gifter77/PCB-reflow-solder-heat-plate/Heatplate_v2.0/Heatplate_v2.0.pdf

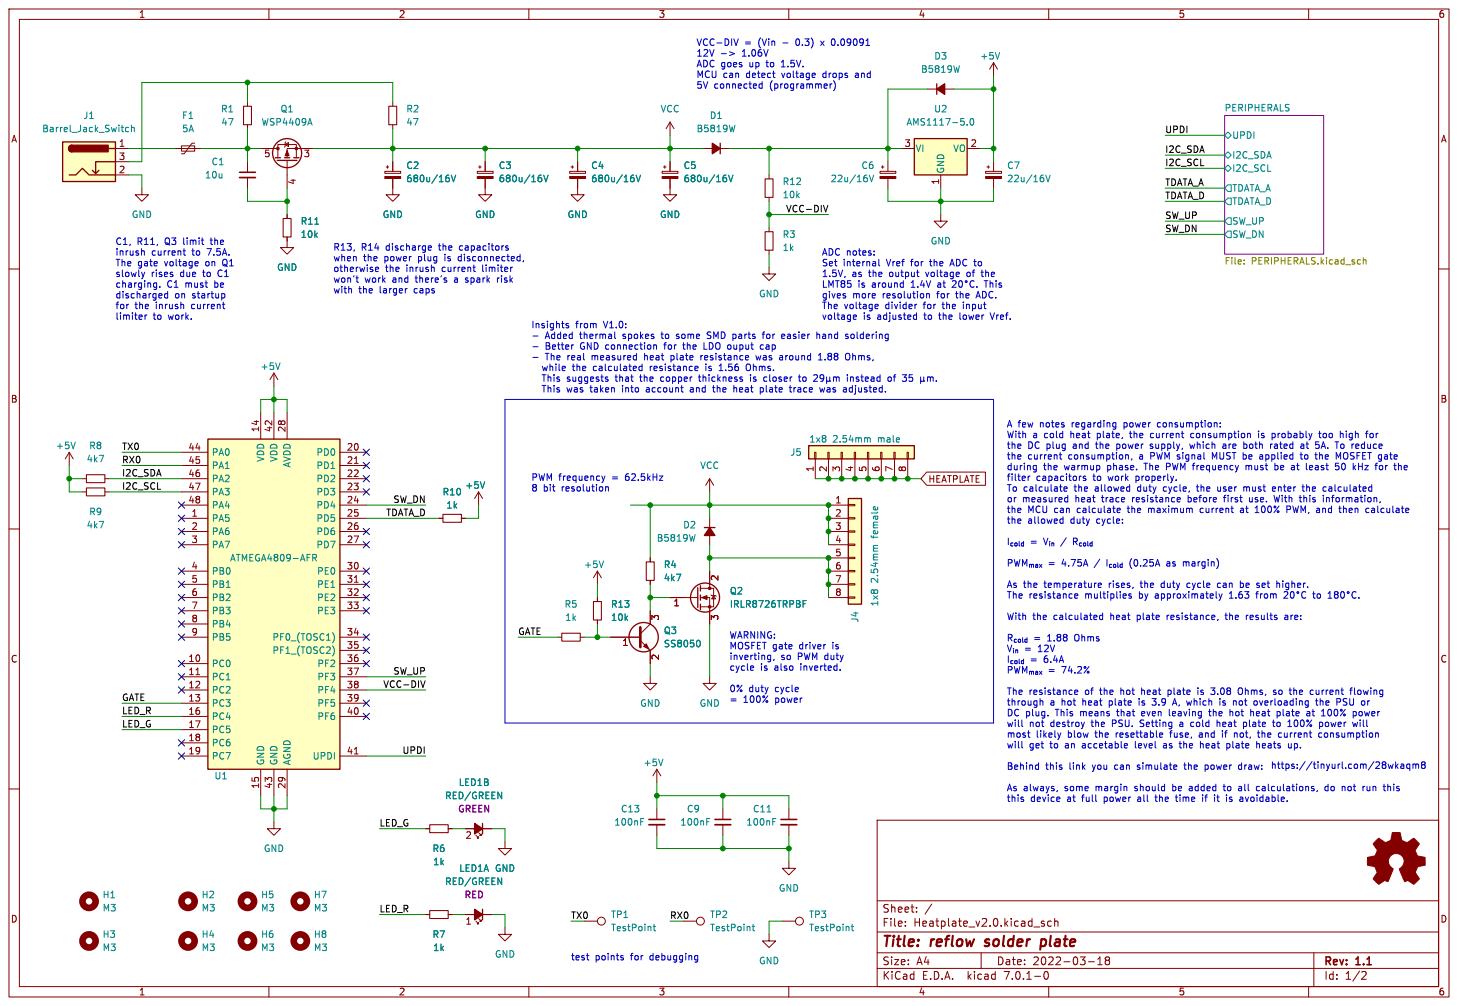
[picture p1: page 1]

VCC-DIV = (Vin - 0.3) x 0.09091
ADC goes up to 1.5V. MCU can detect voltage drops and
GND

SW_UP WARNING: MOSFET gate driver is

inrush current to 7.5A. The gate voltage on Q1
slowly rises due to C1
for the inrush current

1.5V, as the output voltage of the

voltage is adjusted to the lower Vref.

Insights from V1.0: - Added thermal spokes to some SMD parts for easier hand soldering

2 3 Q3 SS8050 PA5 1 PC0 10 PC1 11 PC2 12 PC3 13 VDD 14 GND 15 PC4 16 PC5 17 PC6 18 PC7 19 PA6 2 PD0 20 PD1 21 PD2 22 PD3 23 PD4 24 PD5 25 PD6 26 PD7 27 AVDD 28 AGND 29 PA7 3 PE0 30 PE1 31 PE2 32 PE3 33 PF0_(TOSC1) 34 PF1_(TOSC2) 35 PF2 36 PF3 37 PF4 38 PF5 39 PB0 4 PF6 40 UPDI 41 VDD 42 GND 43 PA0 44 PA1 45 PA2 46 PA3 47 PA4 48 PB1 5 PB2 6 PB3 7 PB4 8 PB5 9 U1 ATMEGA4809-AFR GND

the DC plug and the power supply, which are both rated at 5A. To reduce

the allowed duty cycle:

this device at full power all the time if it is avoidable.

Id: 1/2 Title: reflow solder plate

test points for debugging

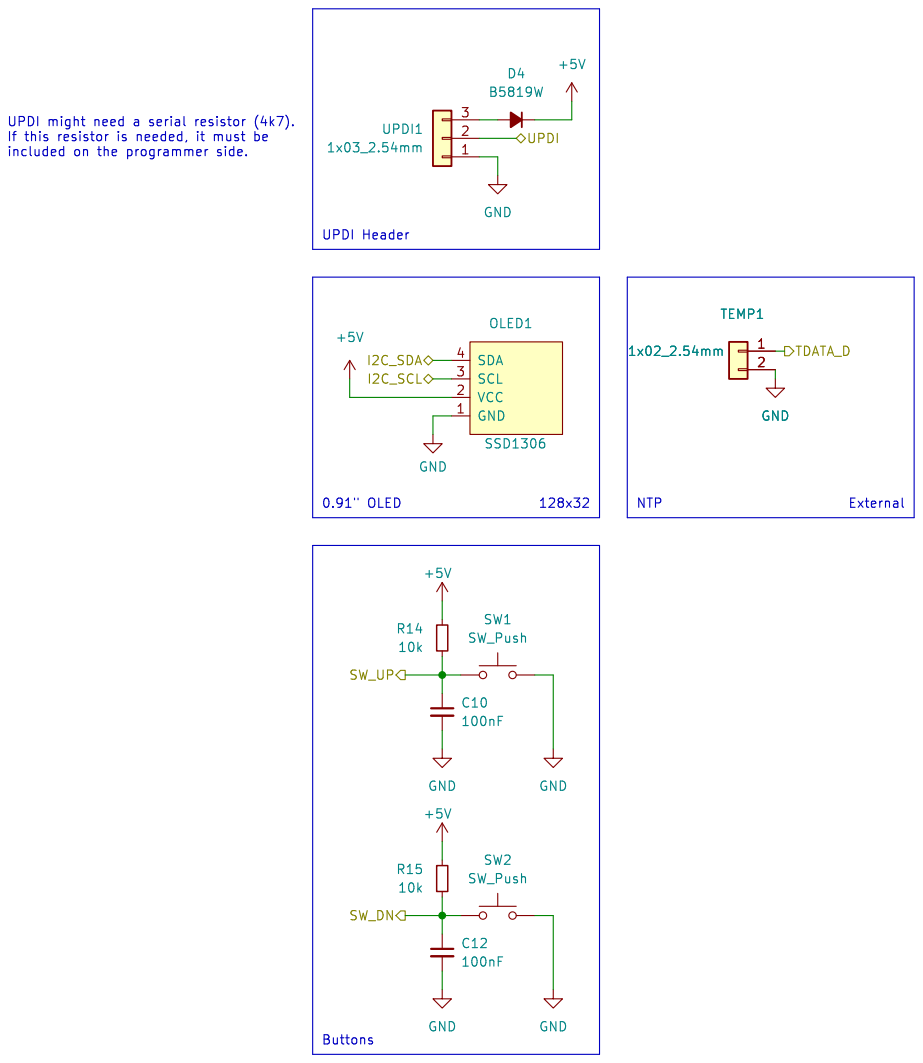
[picture p2: page 2]
