gifter77/PCB-reflow-solder-heat-plate/Heatplate_v2.0/Heatplate_v2.0.kicad_pcb

## KiCad design Heatplate_v2.0/Heatplate_v2.0.kicad_pcb (2023-04-24)

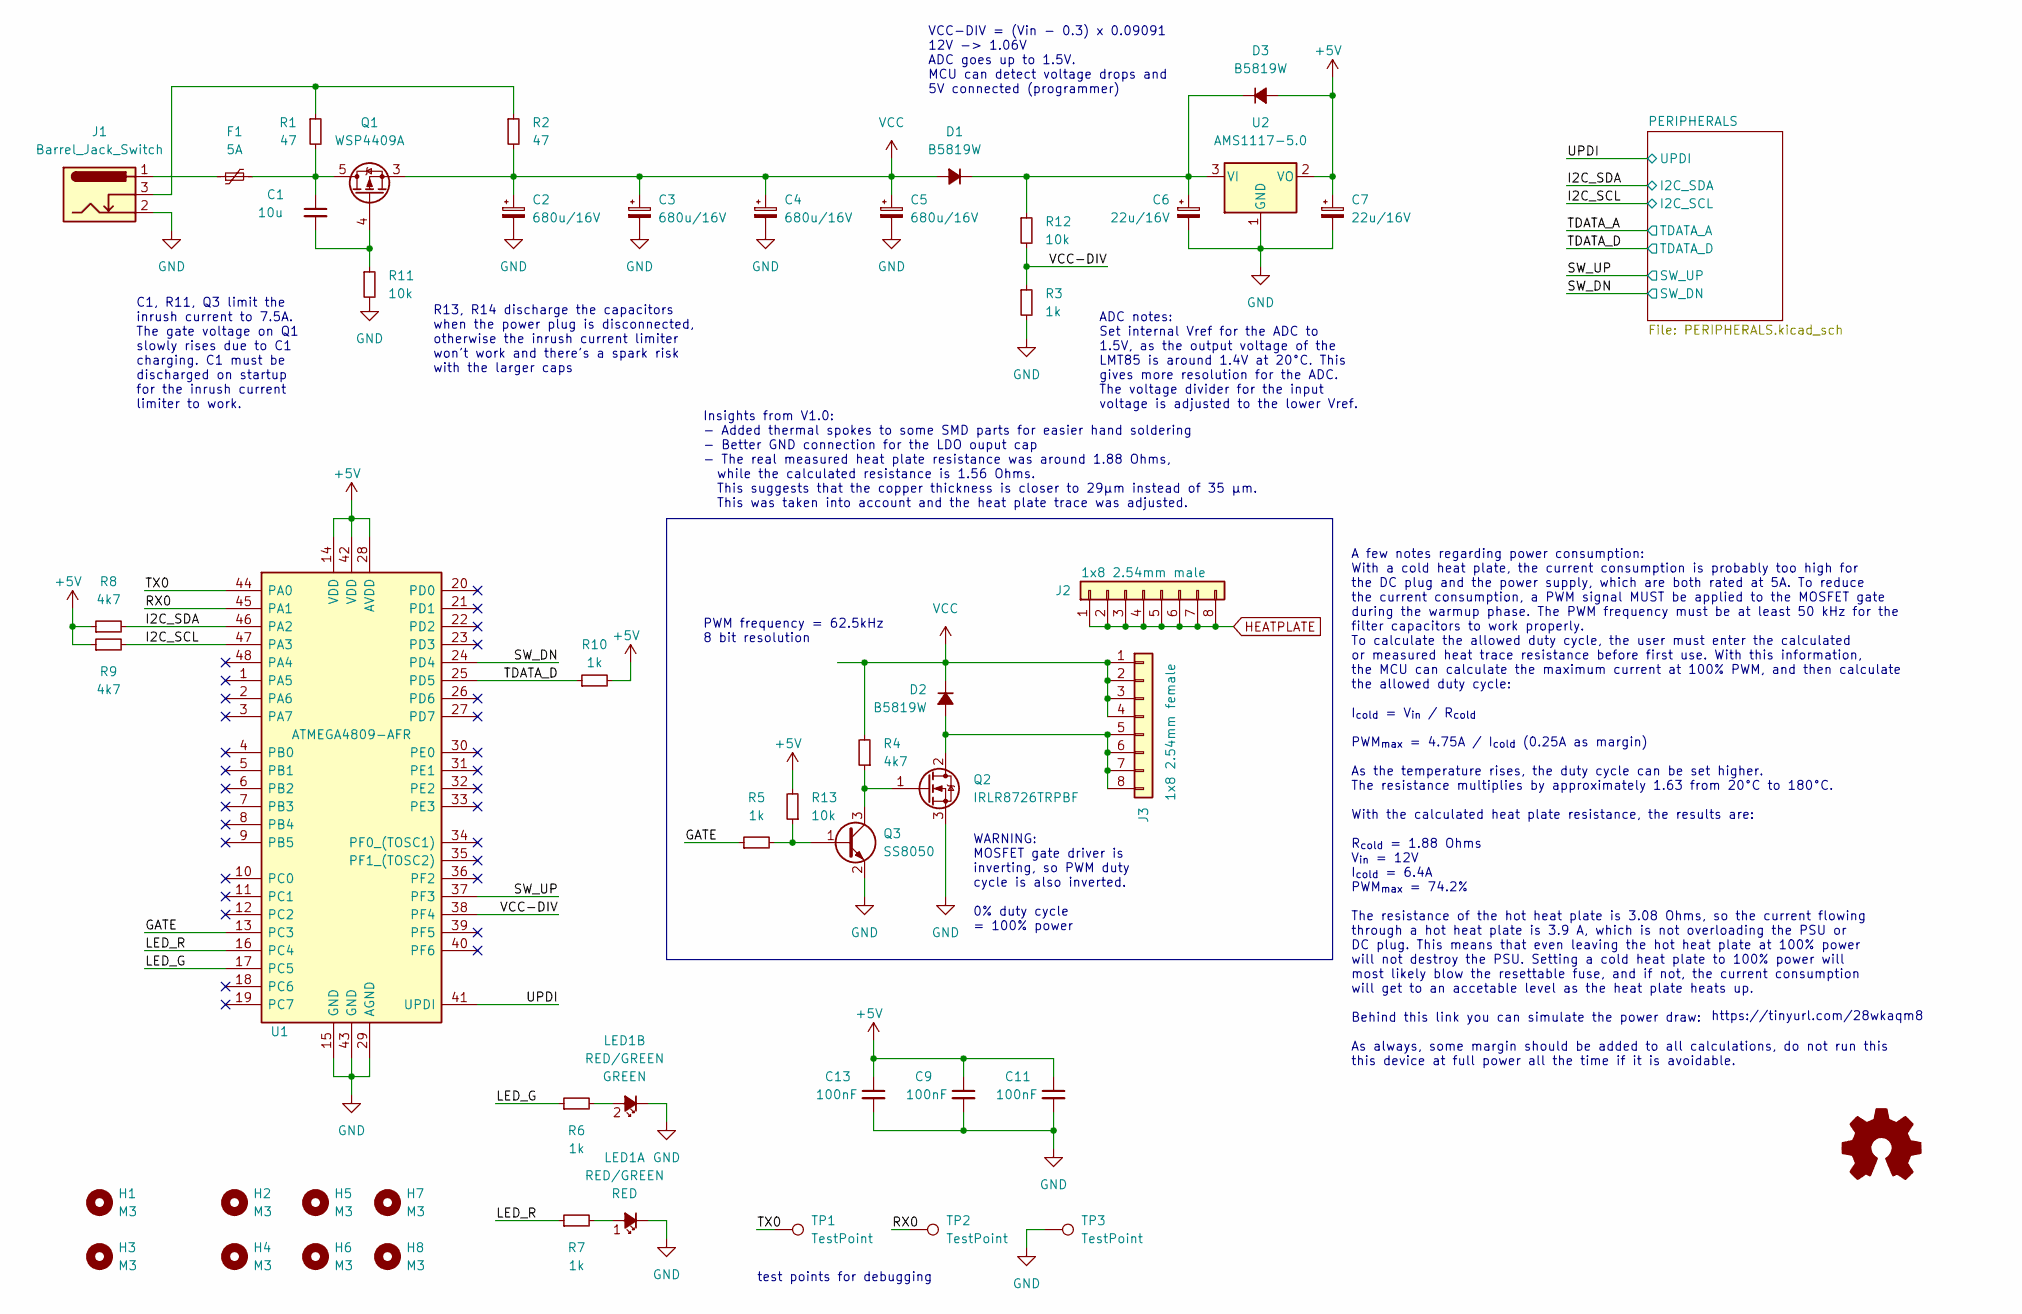
[picture p3: schematic Heatplate_v2.0.kicad_sch, reflow solder plate]

Parts:
C1: 10u; C_0805_2012Metric; LCSC Part Number C2922480
C2, C3, C4, C5: 680u/16V; CP_Radial_D8.0mm_P3.50mm; LCSC Part Number C88760
C6, C7: 22u/16V; CP_Elec_4x5.4; LCSC Part Number C88799
C9, C11, C13: 100nF; C_0805_2012Metric; LCSC Part Number C1711
D1, D2, D3: B5819W; D_SOD-123; LCSC Part Number C64885
F1: 5A; Fuse_2920_7451Metric; LCSC Part Number C910846
H1, H2, H3, H4, H5, H6, H7, H8: M3; MountingHole_3.2mm_M3; LCSC Part Number C551332
J1: Barrel_Jack_Switch; BarrelJack_Horizontal; LCSC Part Number C381115
J2: 1x8 2.54mm male; PinHeader_1x08_P2.54mm_Horizontal; LCSC Part Number C2905427
J3: 1x8 2.54mm female; PinSocket_1x08_P2.54mm_Horizontal; LCSC Part Number C2932682
LED1: RED/GREEN; LED_Avago_PLCC4_3.2x2.8mm_CW; LCSC Part Number C131251
LOGO1: Logo_Open_Hardware_Small; OSHW-Logo2_7.3x6mm_SilkScreen
Q1: WSP4409A; SOIC-8_3.9x4.9mm_P1.27mm; LCSC Part Number C2880527
Q2: IRLR8726TRPBF; TO-252-2; LCSC Part Number C81137
Q3: SS8050; SOT-23; LCSC Part Number C444722
R1, R2: 47; R_0805_2012Metric; LCSC Part Number C17714
R3, R5, R6, R7: 1k; R_0805_2012Metric; LCSC Part Number C17513
R4, R8, R9: 4k7; R_0805_2012Metric; LCSC Part Number C17673
R10: 1k; R_0805_2012Metric; LCSC Part Number C17673
R11, R12, R13: 10k; R_0805_2012Metric; LCSC Part Number C17414
TP1, TP2, TP3: TestPoint; TestPoint_Pad_D1.5mm
U1: ATMEGA4809-AFR; TQFP-48_7x7mm_P0.5mm; Manufacturer_Part_Number ATMEGA4809-AFR; Mouser Part Number 556-ATMEGA4809-AFR
U2: AMS1117-5.0; SOT-89-3; LCSC Part Number C351450

Connections:
+5V: C7.1, C9.1, C11.1, C13.1, D3.2 (A), R8.1, R9.1, R10.2, R13.2, U1.14 (VDD), U1.28 (AVDD), U1.42 (VDD), U2.2 (VO); also elsewhere on the board
/GATE: R5.1, U1.13 (PC3)
/I2C_SCL: R9.2, U1.47 (PA3); also elsewhere on the board
/I2C_SDA: R8.2, U1.46 (PA2); also elsewhere on the board
/LED_G: R6.1, U1.17 (PC5)
/LED_R: R7.1, U1.16 (PC4)
/RX0: TP2.1, U1.45 (PA1)
/SW_DN: U1.24 (PD4); also elsewhere on the board
/SW_UP: U1.37 (PF3); also elsewhere on the board
/TDATA_D: R10.1, U1.25 (PD5); also elsewhere on the board
/TX0: TP1.1, U1.44 (PA0)
/UPDI: U1.41 (UPDI); also elsewhere on the board
/VCC-DIV: R3.1, R12.2, U1.38 (PF4)
GND: C2.2, C3.2, C4.2, C5.2, C6.2, C7.2, C9.2, C11.2, C13.2, J1.2, LED1.2 (K1), LED1.4 (K2), Q2.3 (S), Q3.2 (E), R3.2, R11.2, TP3.1, U1.15 (GND), U1.29 (AGND), U1.43 (GND), U2.1 (GND); also elsewhere on the board
unnamed: C1.1, F1.2, Q1.5 (D), Q1.6 (D), Q1.7 (D), Q1.8 (D), R1.2
unnamed: C6.1, D1.1 (K), D3.1 (K), R12.1, U2.3 (VI)
unnamed 17: D2.2 (A), Q2.2 (D); also elsewhere on the board
unnamed: F1.1, J1.1
unnamed: J1.3, R1.1, R2.1
unnamed: LED1.1 (A1), R7.2
unnamed: LED1.3 (A2), R6.2
unnamed: C1.2, Q1.4 (G), R11.1
unnamed: Q2.1 (G), Q3.3 (C), R4.1
unnamed: Q3.1 (B), R5.2, R13.1
VCC: C2.1, C3.1, C4.1, C5.1, D1.2 (A), D2.1 (K), Q1.1 (S), Q1.2 (S), Q1.3 (S), R2.2, R4.2; also elsewhere on the board

Notes on the sheet:
C1, R11, Q3 limit the inrush current to 7.5A. The gate voltage on Q1 slowly rises due to C1 charging. C1 must be discharged on startup for the inrush current limiter to work.
VCC-DIV = (Vin - 0.3) x 0.09091 12V -> 1.06V ADC goes up to 1.5V. MCU can detect voltage drops and 5V connected (programmer)
PWM frequency = 62.5kHz 8 bit resolution
A few notes regarding power consumption: With a cold heat plate, the current consumption is probably too high for the DC plug and the power supply, which are both rated at 5A. To reduce the current consumption, a PWM signal MUST be applied to the MOSFET gate during the warmup phase. The PWM frequen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
WARNING: MOSFET gate driver is inverting, so PWM duty cycle is also inverted. 0% duty cycle = 100% power
R13, R14 discharge the capacitors when the power plug is disconnected, otherwise the inrush current limiter won't work and there's a spark risk with the larger caps
https://tinyurl.com/28wkaqm8
test points for debugging
ADC notes: Set internal Vref for the ADC to 1.5V, as the output voltage of the LMT85 is around 1.4V at 20°C. This gives more resolution for the ADC. The voltage divider for the input voltage is adjusted to the lower Vref.
Insights from V1.0: - Added thermal spokes to some SMD parts for easier hand soldering - Better GND connection for the LDO ouput cap - The real measured heat plate resistance was around 1.88 Ohms, while the calculated resistance is 1.56 Ohms. This suggests that the copper thickness is closer to 29µ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

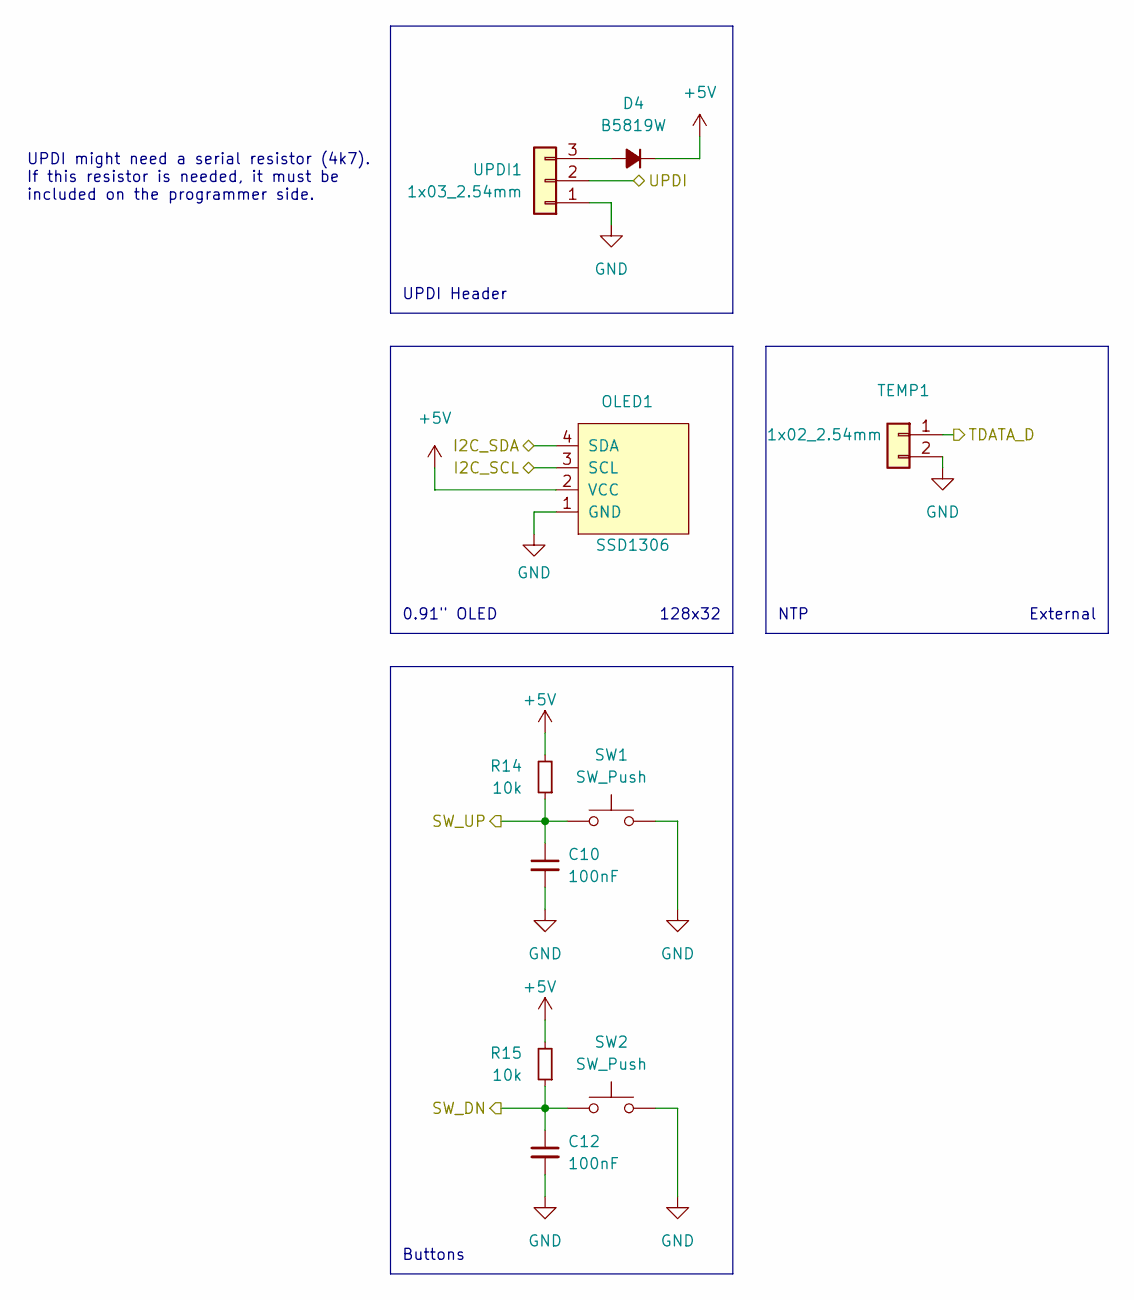
[picture p4: schematic PERIPHERALS.kicad_sch]

Parts:
C10, C12: 100nF; C_0805_2012Metric; LCSC Part Number C1711
D4: B5819W; D_SOD-123; LCSC Part Number C64885
OLED1: SSD1306; 0.91Inch-OLED-Module; LCSC Part Number C2718488
R14, R15: 10k; R_0805_2012Metric; LCSC Part Number C17414
SW1, SW2: SW_Push; SW_PUSH_6mm; LCSC Part Number C136682
TEMP1: 1x02_2.54mm; PinHeader_1x02_P2.54mm_Vertical; LCSC Part Number C2905434
UPDI1: 1x03_2.54mm; PinHeader_1x03_P2.54mm_Vertical; LCSC Part Number C49257

Connections:
+5V: D4.1 (K), OLED1.2 (VCC), R14.2, R15.2; also elsewhere on the board
/I2C_SCL: OLED1.3 (SCL); also elsewhere on the board
/I2C_SDA: OLED1.4 (SDA); also elsewhere on the board
/SW_DN: C12.1, R15.1, SW2.1; also elsewhere on the board
/SW_UP: C10.1, R14.1, SW1.1; also elsewhere on the board
/TDATA_D: TEMP1.1; also elsewhere on the board
/UPDI: UPDI1.2; also elsewhere on the board
GND: C10.2, C12.2, OLED1.1 (GND), SW1.2, SW2.2, TEMP1.2, UPDI1.1; also elsewhere on the board
unnamed: D4.2 (A), UPDI1.3

Notes on the sheet:
NTP
UPDI Header
128x32
0.91" OLED
Buttons
UPDI might need a serial resistor (4k7). If this resistor is needed, it must be included on the programmer side.
External

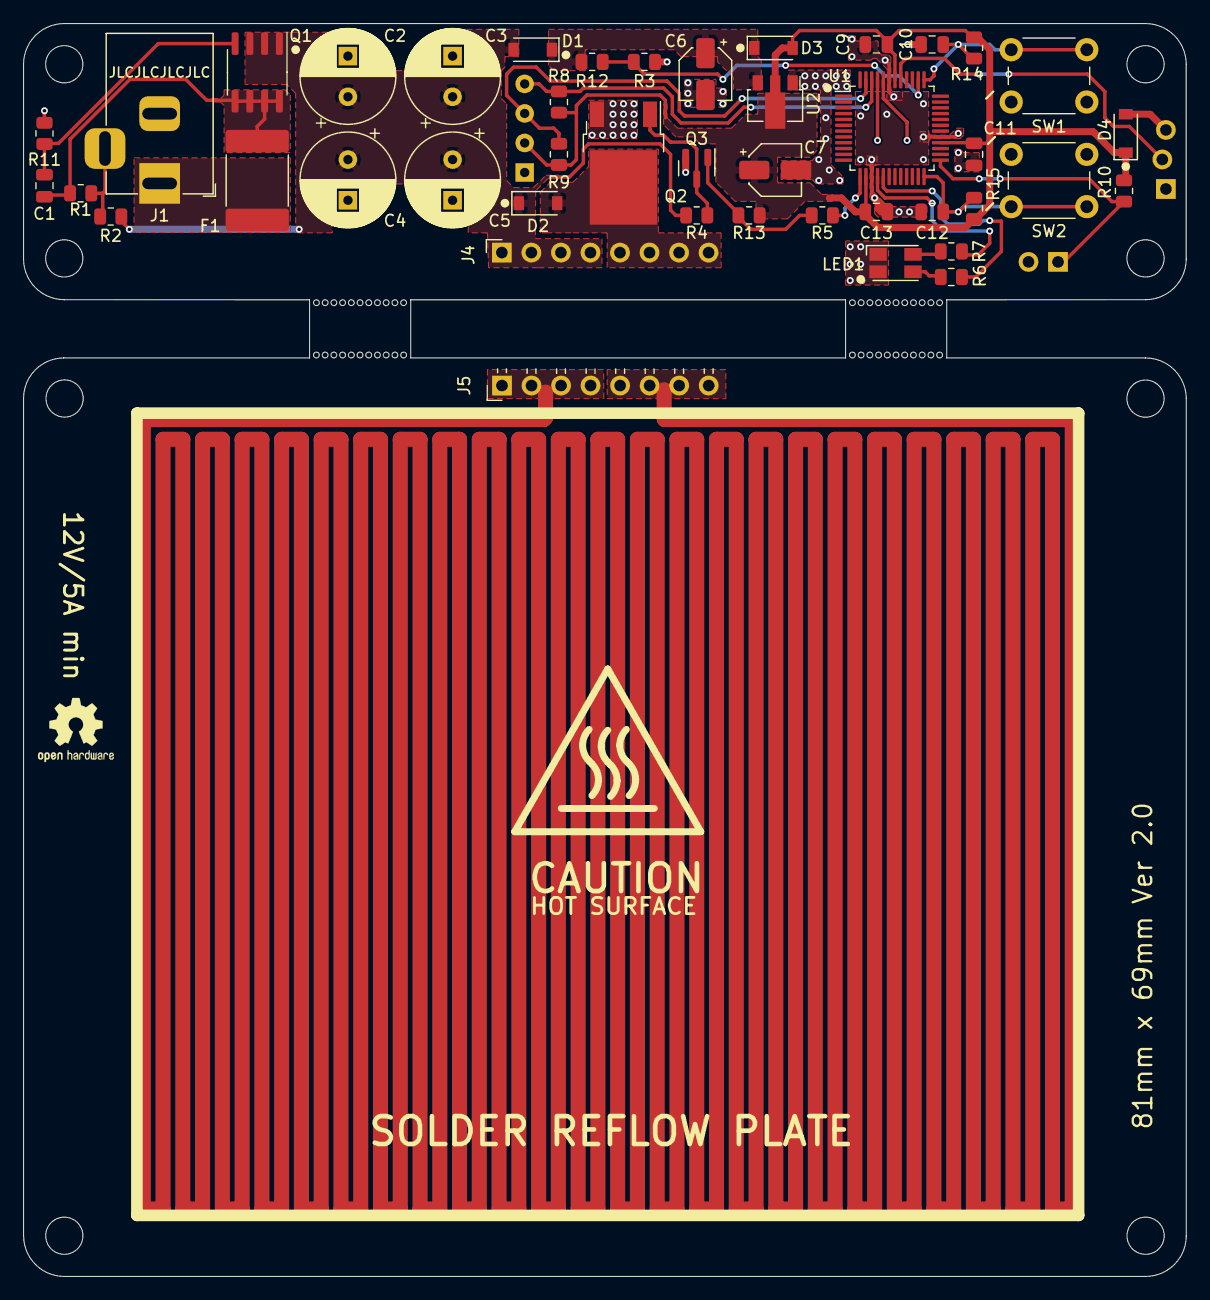
[picture p5: board Heatplate_v2.0.kicad_pcb from above]

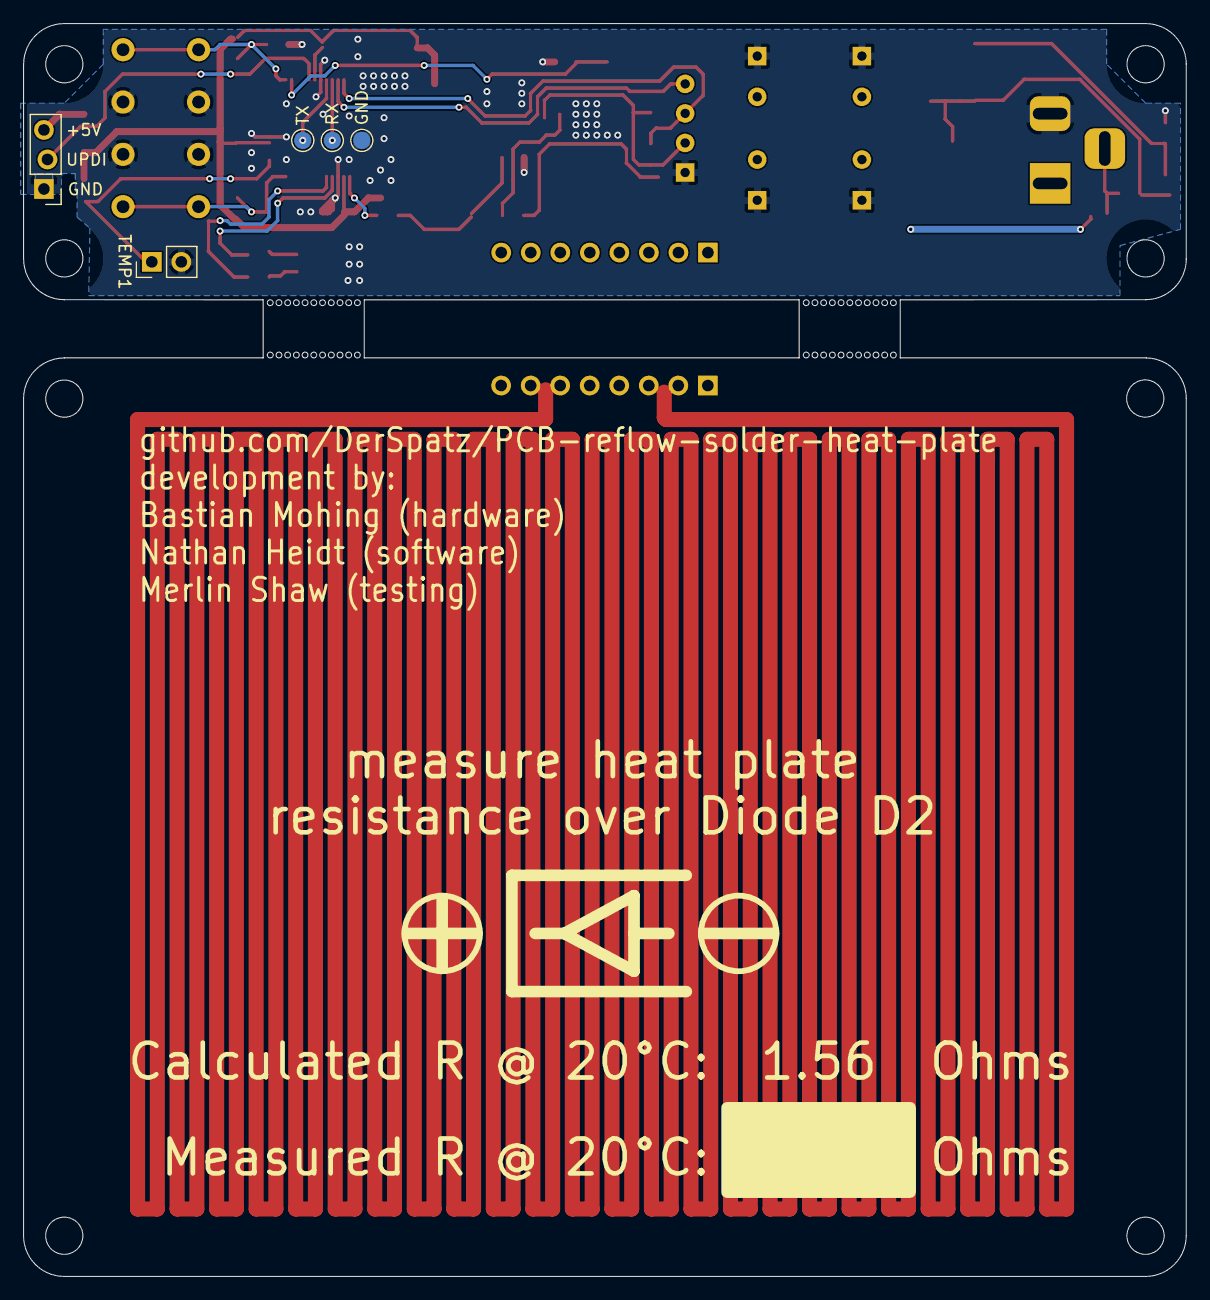
[picture p6: board Heatplate_v2.0.kicad_pcb from below]

Board: 2 copper layers, 100.0 x 107.8 mm, 60 parts (5 on the bottom side), 27 nets.

Other parts of the board:
J4: 1x8 2.54mm female; PinSocket_1x08_P2.54mm_Horizontal
J5: 1x8 2.54mm male; PinHeader_1x08_P2.54mm_Horizontal
mouse-bite-5mm-slot, mouse-bite-5mm-slot#2: VAL**; mouse-bite-5mm-slot

Their connections:
HEATPLATE: J5.1, J5.2, J5.3, J5.4, J5.5, J5.6, J5.7, J5.8
unnamed 17: J4.5, J4.6, J4.7, J4.8; also elsewhere on the board
VCC: J4.1, J4.2, J4.3, J4.4; also elsewhere on the board
