gifter77/PCB-reflow-solder-heat-plate/(commit log)

2023-03-21 Modified code to use NTC thermistor
2023-04-10 Split PCB and heat plate
    [Heatplate_v2.0.kicad_pcb, Heatplate_v2.0.kicad_sch, PERIPHERALS.kicad_sch]
2023-04-24 Minor fixes
    [Heatplate_v2.0.kicad_pcb]
2023-04-24 Squashed commit of the following:
    commit 8e63c85fbbaf13759d6261f9b10b379e95262986
    Author: gifter77 <17034102+gifter77@users.noreply.github.com>
    Date: Mon Apr 24 12:47:02 2023 +0100
    NTC thermistor and PID auto-tuning firmware moved into separate v2 directory
    commit 072c7ec0e5f50c28c2462603dc7d94ad727fff54
    Author: gifter77 <17034102+gifter77@users.noreply.github.com>
    Date: Mon Apr 24 12:45:33 2023 +0100
    Revert "Modified code to use NTC thermistor"
    This reverts commit af9c8fac893489ef4b004f58479b9359fe9118f5.
    commit af9c8fac893489ef4b004f58479b9359fe9118f5
    Author: gifter77 <17034102+gifter77@users.noreply.github.com>
    Date: Tue Mar 21 19:59:05 2023 +0000
    Modified code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
    [pcb_reflow_fw_v2.ino]
